W3PM/GPS-Display-and-Time-Grid-Square-Synchronization-Source/README.md

# GPS Display and Time/Grid Square Synchronization Source
This inexpensive and easy to build small battery powered device will not only provide time synchronization for the W3PM WSPR project, but makes an ideal pocket sized travel companion.

Displayed GPS parameters include:
    • Time
    • Day of the week and date
    • Grid square
    • Number of satellites in view
    • Latitude and longitude
    • Speed (knots, kph, mph)
    • Altitude (meters and feet)
    • Distance to home or other selected location (km and miles)
    • Bearing to home or other selected location
